blueberrymuffin3/rocket_tracker/rocket/Rocket.FCStd

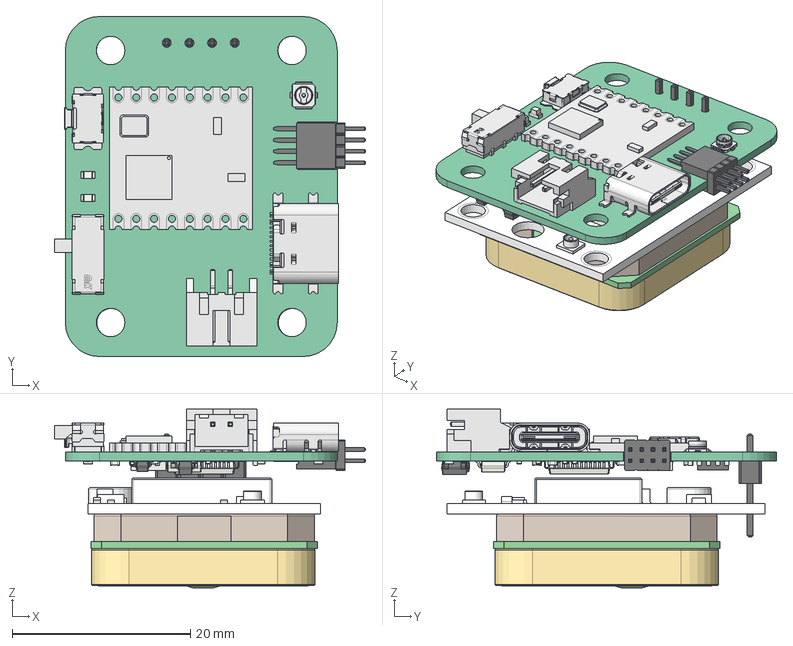
[picture p1: CAD file, 2020-06-28]
rocket/Rocket.FCStd
34.9 x 38.1 x 20.0 mm
Pcb_d1a1
SW1_1_5EF4BBB3
SW2_1_5EF29B9F
J2_JST-PH_5EF29A84
J3_USB4110-GF-A--3DModel-STEP-56544_5EF4E811
J4_u.Fl Antenna Connector - 523-A-1JB_5EF4C1D5
D4_LED_0603_1608Metric_5EF299FC
D3_LED_0603_1608Metric_5EF299E9
U4_RFM95W-915S2--3DModel-STEP-56544_5EF2D7C4
J1_PinSocket_2x04_P127mm_Vertical_5EF35816
J1_PinHeader_2x04_P127mm_Vertical_5EF35816[2]
C14_C_0402_1005Metric_5EF39FFB
U7_Chip_5EF3A06F
C15_C_0402_1005Metric_5EF3A025
C9_C_0402_1005Metric_5EF35E3C
C8_C_0402_1005Metric_5EF35E2D
C7_C_0402_1005Metric_5EF35E1E
D1_D_SOD_123_5EF604A8
U6_QFN_24_1EP_4x4mm_P05mm_EP27x26mm_5EF6089E
U2_SOT_23_5EF35C41
U1_SOT_23_5_5EF6072E
R8_R_0402_1005Metric_5EF606B3
R5_R_0402_1005Metric_5EF6066C
R4_R_0402_1005Metric_5EF6065D
R3_R_0402_1005Metric_5EF6064E
D2_D_SOD_123_5EF604C1
C13_C_0402_1005Metric_5EF6048F
C12_C_0402_1005Metric_5EF60480
C11_C_0402_1005Metric_5EF60471
C10_C_0402_1005Metric_5EF60462
C6_C_0402_1005Metric_5EF60453
C5_C_0402_1005Metric_5EF63C81
C4_C_0402_1005Metric_5EF60435
C3_C_0402_1005Metric_5EF60426
C2_C_0402_1005Metric_5EF60417
C1_C_0402_1005Metric_5EF60408
Y1_Crystal_SMD_3225-4Pin_3.2x2.5mm_5EF6278B
U5_LQFP_48_7x7mm_P05mm_5EF5F0A1
R7_R_0402_1005Metric_5EF5EF6F
R6_R_0402_1005Metric_5EF5EF45
R2_R_0402_1005Metric_5EF29AEB
R1_R_0402_1005Metric_5EF29ADC
PinHeader_1x04_P254mm_Vertical
GPS_ublox_board
GPS_board
GPS_ant
GPS_back
