blueberrymuffin3/rocket_tracker/rocket/rocket.kicad_pcb

## KiCad design rocket/rocket.kicad_pcb (2020-06-28)

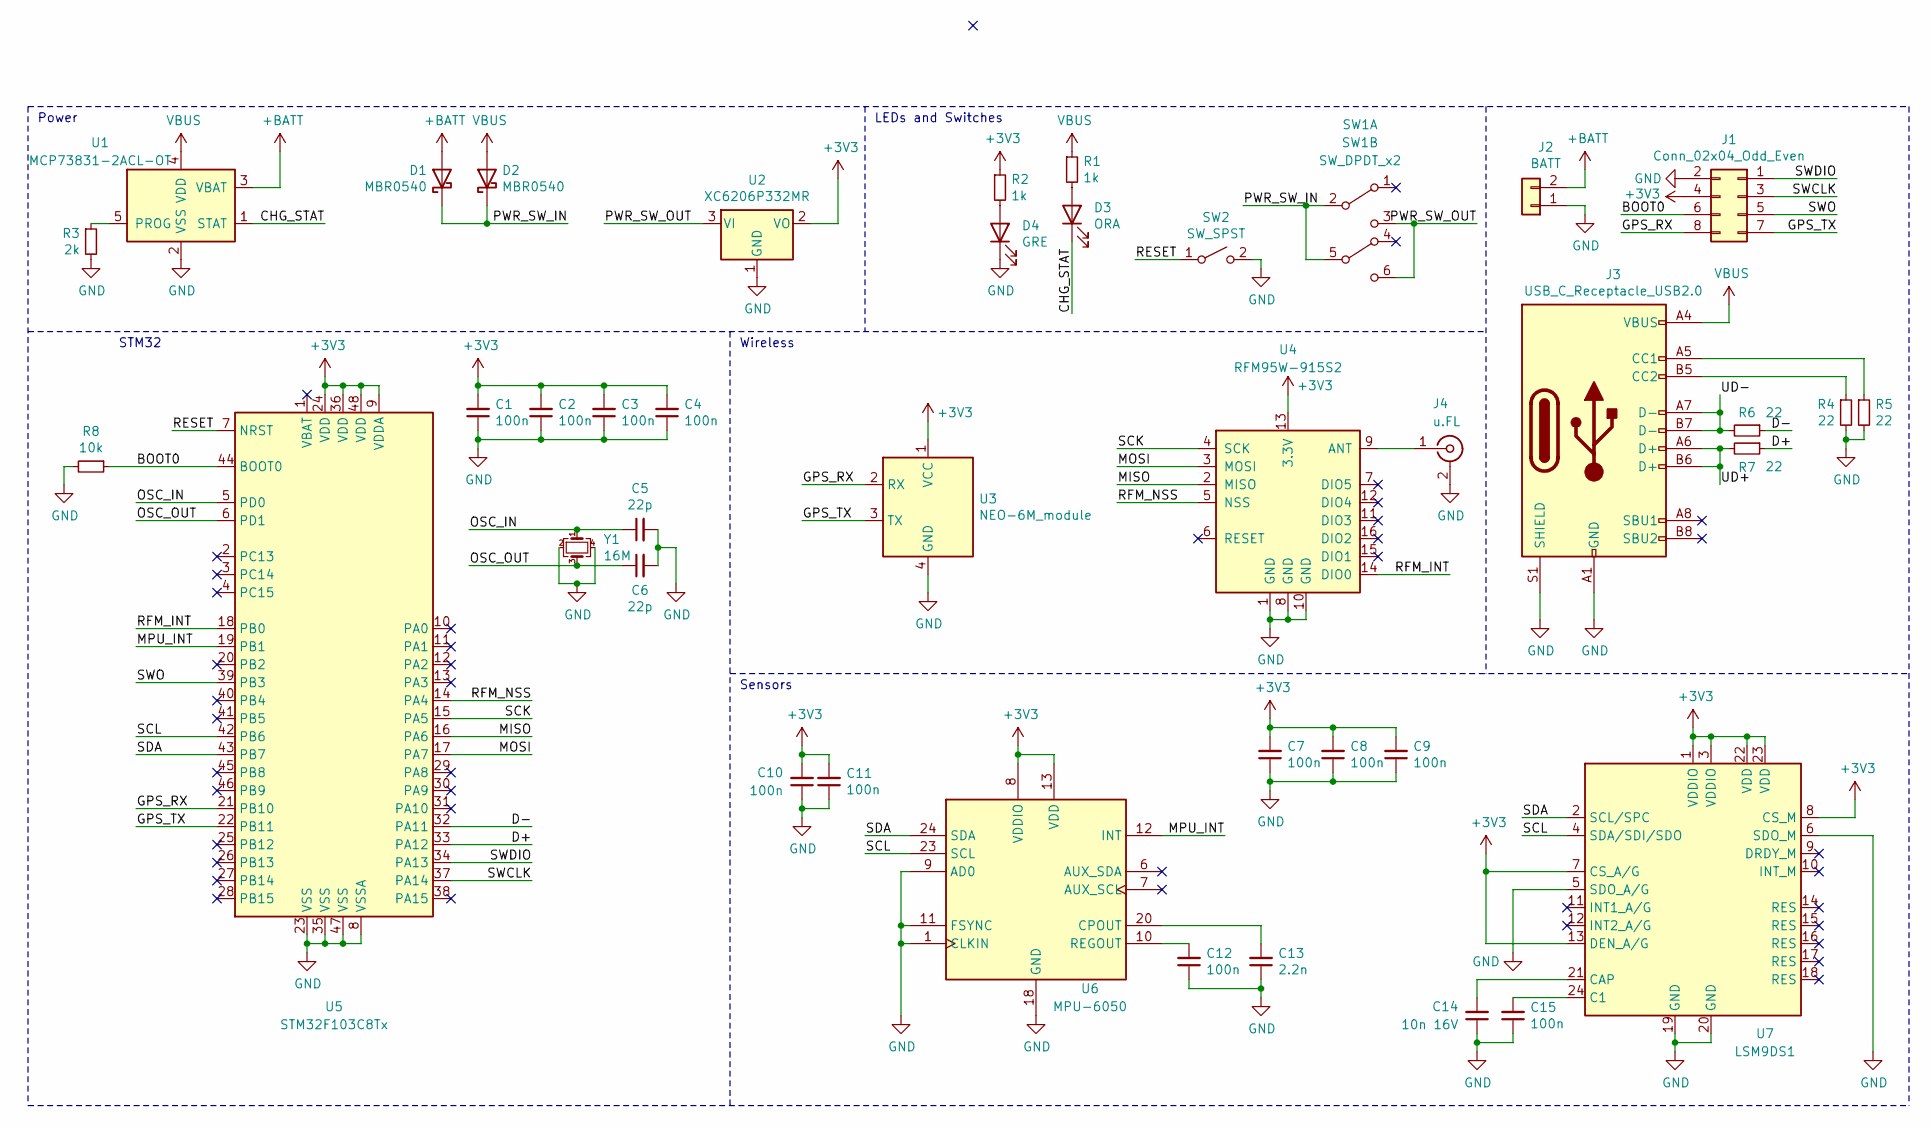
[picture p2: schematic rocket.sch]

Parts:
C1, C2, C3, C4, C7, C8, C9, C10, C11, C12, C15: 100n; C_0402_1005Metric; JLCPCB # C1525
C5, C6: 22p; C_0402_1005Metric; JLCPCB # C1555
C13: 2.2n; C_0402_1005Metric; JLCPCB # C1531
C14: 10n 16V; C_0402_1005Metric; JLCPCB # C15195
D1, D2: MBR0540; D_SOD-123; DIGIKEY # MBR0540TPMSCT-ND
D3: ORA; LED_0603_1608Metric; DIGIKEY # 160-1445-1-ND
D4: GRE; LED_0603_1608Metric; DIGIKEY # 160-1446-1-ND
J1: Conn_02x04_Odd_Even; PinSocket_2x04_P1.27mm_Horizontal_Straddle; DIGIKEY # 609-3753-ND, 609-3753-ND, 2057-RS1-04-G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
J2: BATT; JST_PH_S2B-PH-SM4-TB_1x02-1MP_P2.00mm_Horizontal; DIGIKEY # 455-1749-1-ND
J3: USB_C_Receptacle_USB2.0; GCT_USB4110-GF-A; DIGIKEY # 2073-USB4110-GF-A-1-ND
J4: u.FL; U.FL_Molex_MCRF_73412-0110_Vertical; DIGIKEY # A118077CT-ND
R1, R2: 1k; R_0402_1005Metric; JLCPCB # C11702
R3: 2k; R_0402_1005Metric; JLCPCB # C4109
R4, R5, R6, R7: 22; R_0402_1005Metric; JLCPCB # C25092
R8: 10k; R_0402_1005Metric; JLCPCB # C25744
SW1: SW_DPDT_x2; SW_DPDT_CK_JS202011JAQN; DIGIKEY # CKN10722CT-ND
SW2: SW_SPST; SW_Push_1P1T_KSS231; DIGIKEY # 401-1098-1-ND
U1: MCP73831-2ACL-OT; SOT-23-5; DIGIKEY # MCP73831T-2ACI/OTCT-ND
U2: XC6206P332MR; SOT-23; JLCPCB # C5446
U3: NEO-6M_module
U4: RFM95W-915S2; HOPERF_RFM9XW_SMD; DIGIKEY # RFM95W-915S2-ND
U5: STM32F103C8Tx; LQFP-48_7x7mm_P0.5mm; JLCPCB # C8734
U6: MPU-6050; InvenSense_QFN-24_4x4mm_P0.5mm; JLCPCB # C24112
U7: LSM9DS1; LGA-24L_3x3.5mm_P0.43mm_Handsolder; DIGIKEY # 497-14946-1-ND
Y1: 16M; Crystal_SMD_3225-4Pin_3.2x2.5mm; JLCPCB # C13738

Connections:
+3V3: C1.2, C2.2, C3.2, C4.2, C7.2, C8.2, C9.2, C10.2, C11.2, J1.4, R2.1, U2.2 (VO), U3.1 (VCC), U4.13 (3.3V), U5.9 (VDDA), U5.24 (VDD), U5.36 (VDD), U5.48 (VDD), U6.8 (VDDIO), U6.13 (VDD), U7.1 (VDDIO), U7.3 (VDDIO), U7.7 (CS_A/G), U7.8 (CS_M), U7.13 (DEN_A/G), U7.22 (VDD), U7.23 (VDD)
+BATT: D1.2 (A), J2.2, U1.3 (VBAT)
/BOOT0: J1.6, R8.1, U5.44 (BOOT0)
/CHG_STAT: D3.1 (K), U1.1 (STAT)
/D+: R7.1, U5.33 (PA12)
/D-: R6.1, U5.32 (PA11)
/GPS_RX: J1.8, U3.2 (RX), U5.21 (PB10)
/GPS_TX: J1.7, U3.3 (TX), U5.22 (PB11)
/MISO: U4.2 (MISO), U5.16 (PA6)
/MOSI: U4.3 (MOSI), U5.17 (PA7)
/MPU_INT: U5.19 (PB1), U6.12 (INT)
/OSC_IN: C5.1, U5.5 (PD0), Y1.1
/OSC_OUT: C6.1, U5.6 (PD1), Y1.3
/PWR_SW_IN: D1.1 (K), D2.1 (K), SW1.2 (B), SW1.5 (B)
/PWR_SW_OUT: SW1.3 (C), SW1.6 (C), U2.3 (VI)
/RESET: SW2.1 (A), U5.7 (NRST)
/RFM_INT: U4.14 (DIO0), U5.18 (PB0)
/RFM_NSS: U4.5 (NSS), U5.14 (PA4)
/SCK: U4.4 (SCK), U5.15 (PA5)
/SCL: U5.42 (PB6), U6.23 (SCL), U7.4 (SDA/SDI/SDO)
/SDA: U5.43 (PB7), U6.24 (SDA), U7.2 (SCL/SPC)
/SWCLK: J1.3, U5.37 (PA14)
/SWDIO: J1.1, U5.34 (PA13)
/SWO: J1.5, U5.39 (PB3)
/UD+: J3.A6 (D+), J3.B6 (D+), R7.2
/UD-: J3.A7 (D-), J3.B7 (D-), R6.2
GND: C1.1, C2.1, C3.1, C4.1, C5.2, C6.2, C7.1, C8.1, C9.1, C10.1, C11.1, C12.1, C13.1, C14.1, C15.1, D4.1 (K), J1.2, J2.1, J3.A1 (GND), J3.A12 (GND), J3.B1 (GND), J3.B12 (GND), J3.S1 (SHIELD), J4.2 (Ext), R3.2, R4.2, R5.2, R8.2, SW2.2 (B), U1.2 (VSS), U2.1 (GND), U3.4 (GND), U4.1 (GND), U4.8 (GND), U4.10 (GND), U5.8 (VSSA), U5.23 (VSS), U5.35 (VSS), U5.47 (VSS), U6.1 (CLKIN), U6.9 (AD0), U6.11 (FSYNC), U6.18 (GND), U7.5 (SDO_A/G), U7.6 (SDO_M), U7.19 (GND), U7.20 (GND), Y1.2, Y1.4
unnamed: C12.2, U6.10 (REGOUT)
unnamed: C13.2, U6.20 (CPOUT)
unnamed: C14.2, U7.21 (CAP)
unnamed: C15.2, U7.24 (C1)
unnamed: D3.2 (A), R1.2
unnamed: D4.2 (A), R2.2
unnamed: J3.A5 (CC1), R5.1
unnamed: J3.B5 (CC2), R4.1
unnamed: J4.1 (In), U4.9 (ANT)
unnamed: R3.1, U1.5 (PROG)
VBUS: D2.2 (A), J3.A4 (VBUS), J3.A9 (VBUS), J3.B4 (VBUS), J3.B9 (VBUS), R1.1, U1.4 (VDD)

Notes on the sheet:
Power
STM32
LEDs and Switches
Wireless
Sensors

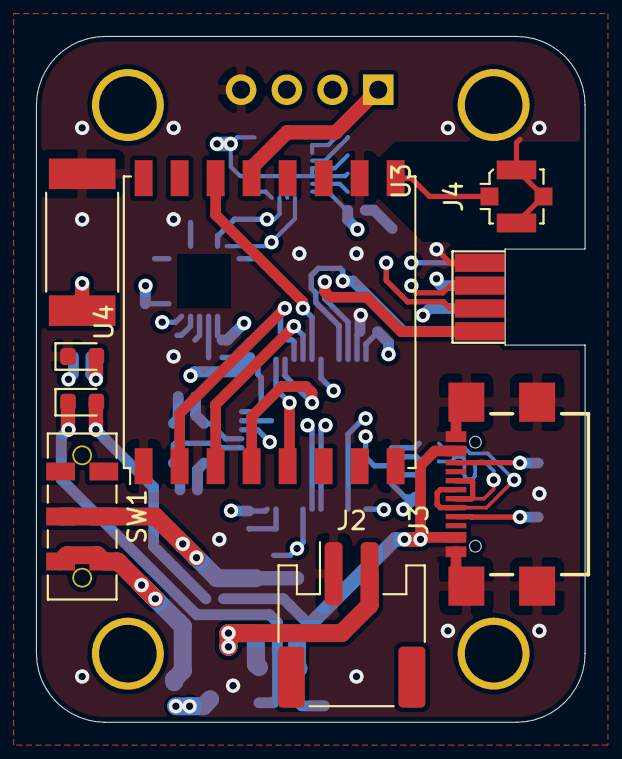
[picture p3: board rocket.kicad_pcb from above]

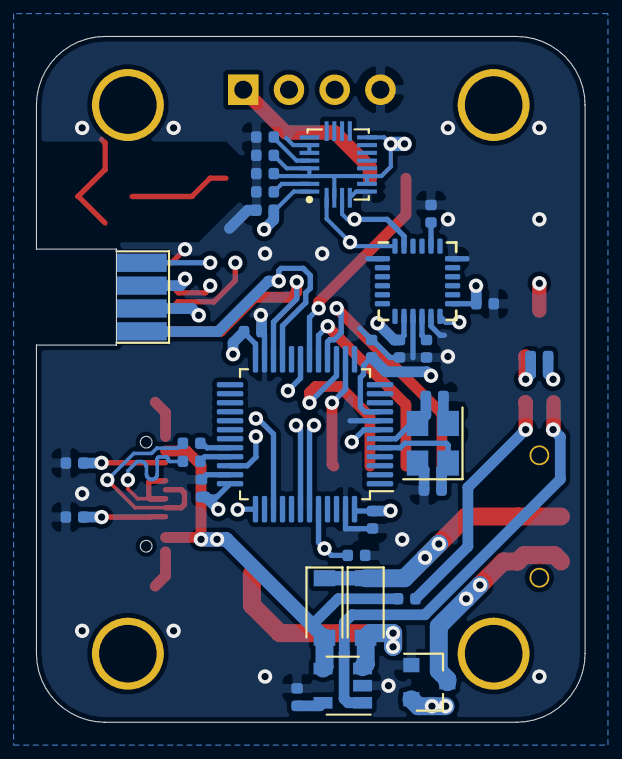
[picture p4: board rocket.kicad_pcb from below]

Board: 4 copper layers, 30.5 x 38.1 mm, 41 parts (32 on the bottom side), 38 nets.
